NerfyGek0/MeshtasticIOAddon/(list of files, drawings)

Other design files:
GateBoard.fzz
